phildimond/AlarmController/README.md

# AlarmController
 ESP32 Ethernet Alarm controller with MQTT integration
