phildimond/AlarmController/Hardware/Alarm input and PSU notes.pdf

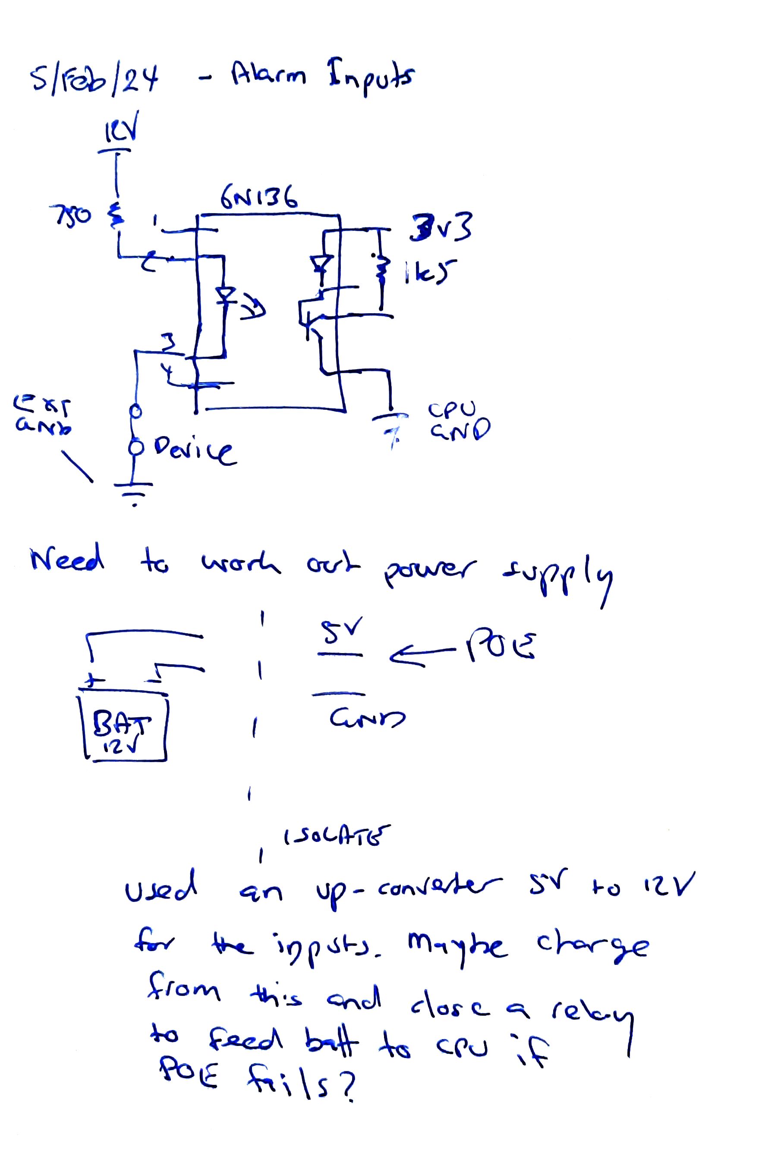
[picture p1: page 1]
