phildimond/AlarmController/Hardware/BatteryCharger/Charger Schematic.png

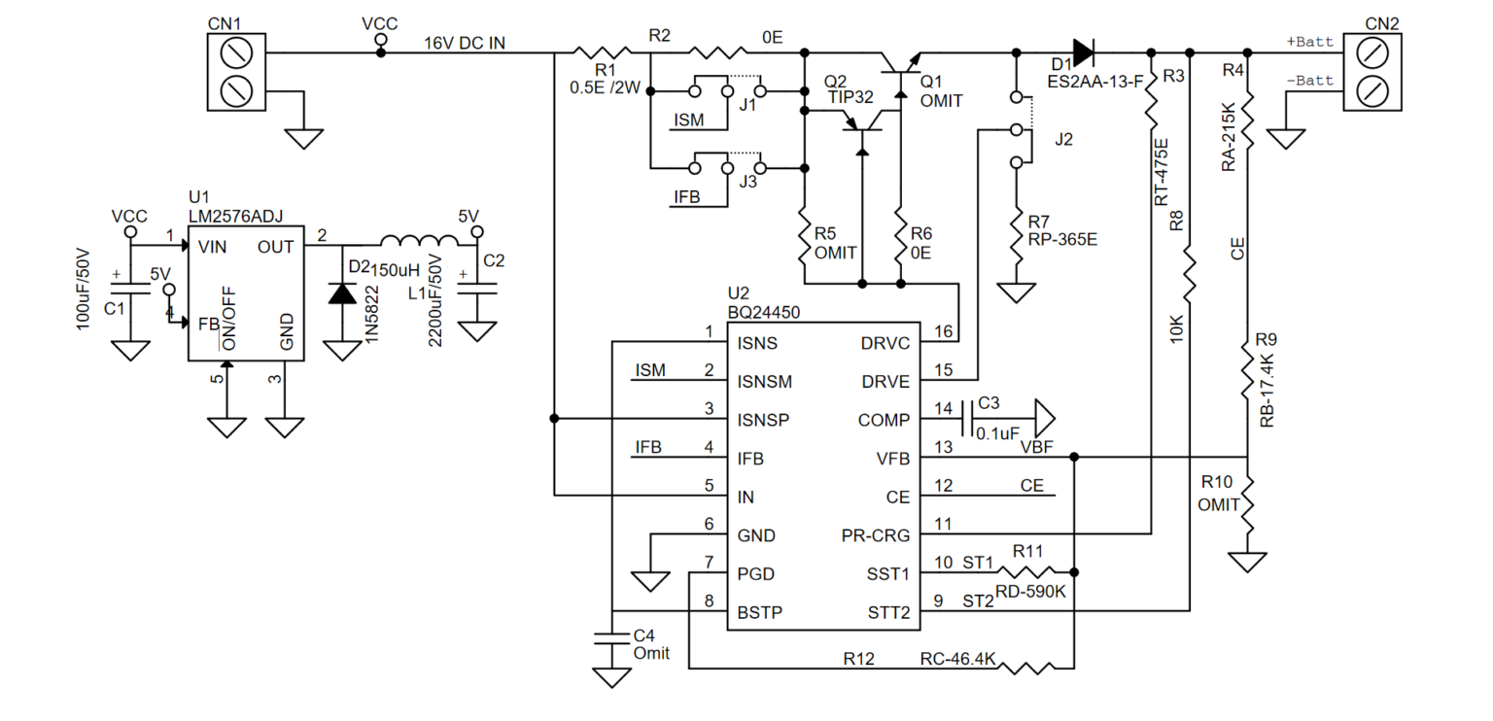
Hardware/BatteryCharger/Charger Schematic.png
