phildimond/AlarmController/Hardware/AlarmUnit/AlarmUnit.pdf

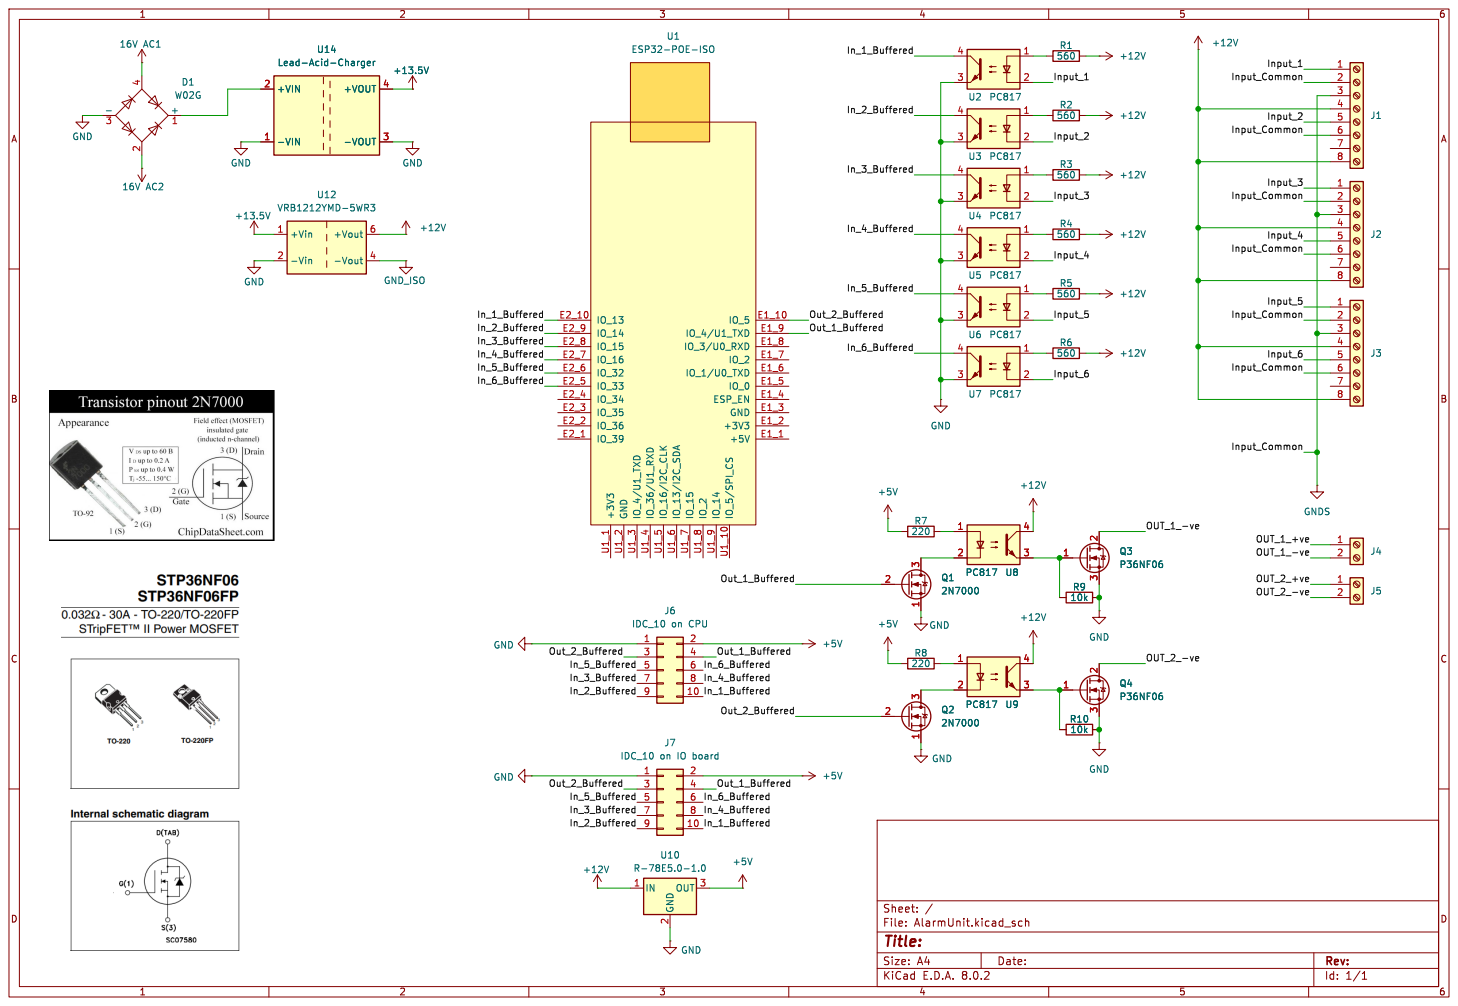
[picture p3: page 1]

IDC_10 on IO board
Id: 1/1 Title: File: AlarmUnit.kicad_sch Sheet: / 1
