phildimond/AlarmController/Hardware/BatteryCharger/Manufacturing/Battery Charger Schematic.pdf

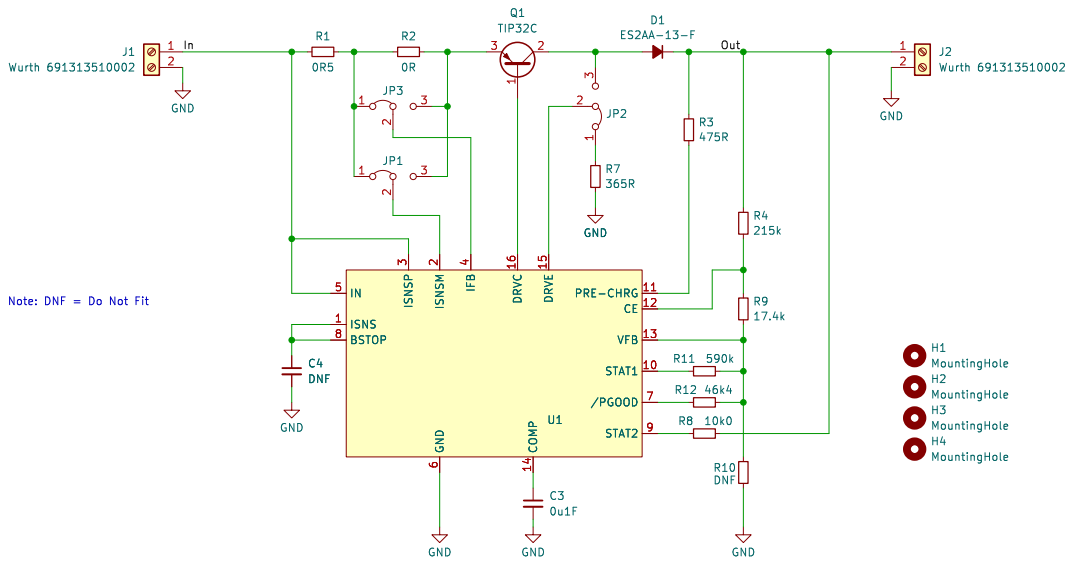
[picture p4: page 1]

H3 MountingHole H4 MountingHole H2 MountingHole H1 MountingHole R3
