phildimond/AlarmController/Hardware/BatteryCharger/Manufacturing/Battery Charger Board Check Actual.pdf

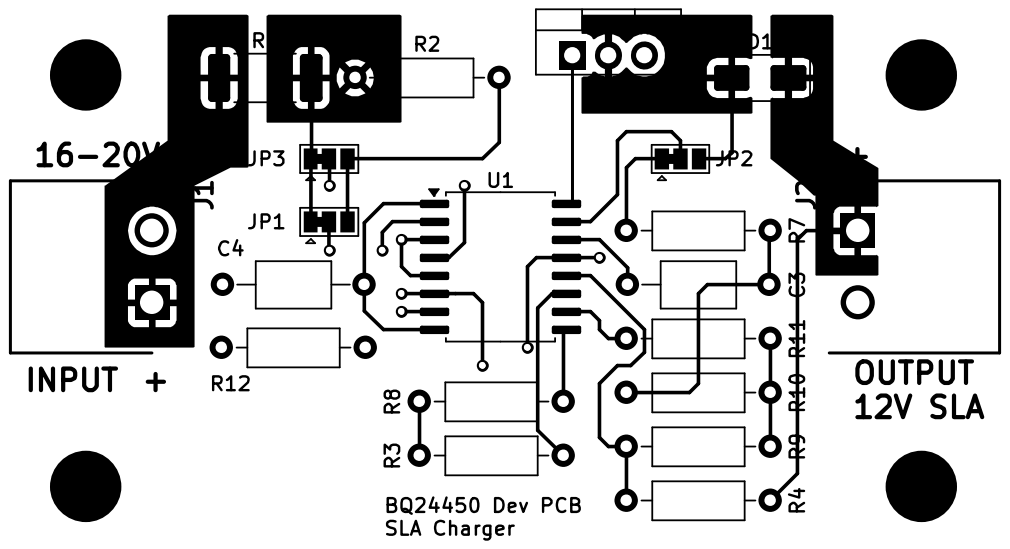
[picture p5: page 1]
