phildimond/AlarmController/Hardware/BatteryCharger/BatteryCharger.kicad_pcb

## KiCad design Hardware/BatteryCharger/BatteryCharger.kicad_pcb (2024-03-03)

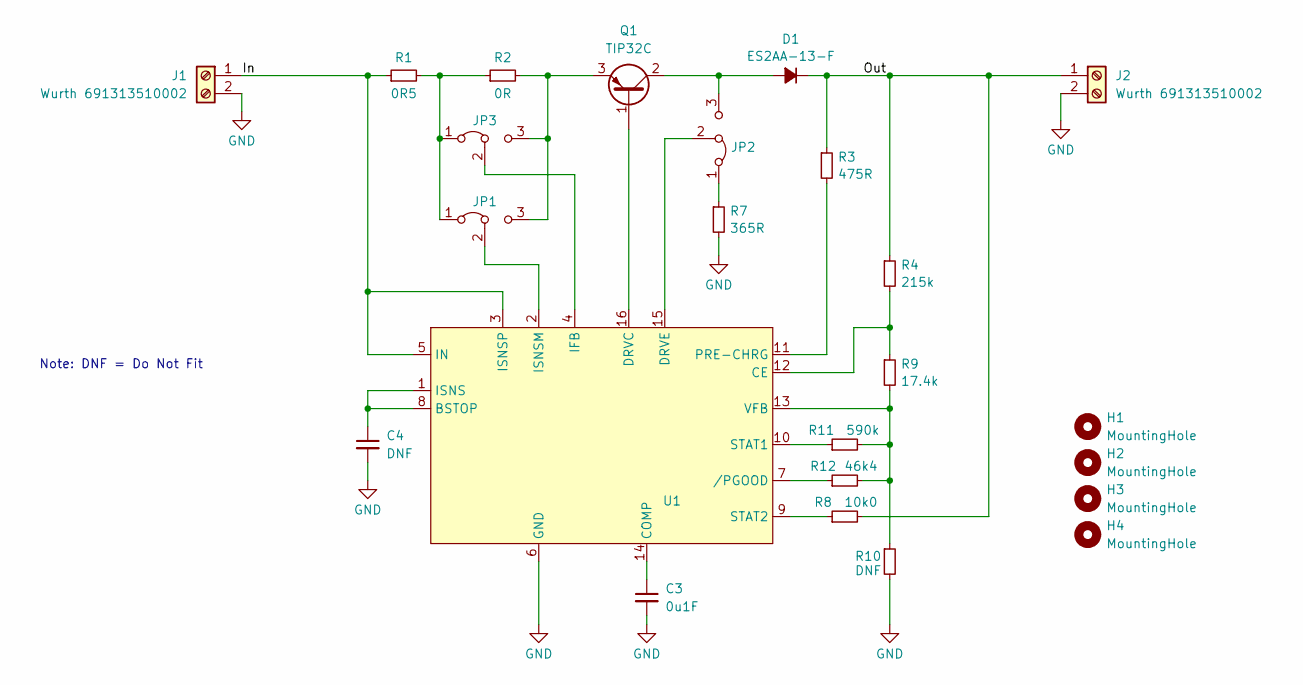
[picture p9: schematic BatteryCharger.kicad_sch]

Parts:
C3: 0u1F; C_Axial_L5.1mm_D3.1mm_P10.00mm_Horizontal
C4: DNF; C_Axial_L5.1mm_D3.1mm_P10.00mm_Horizontal
D1: ES2AA-13-F; D_SMA
H1, H2, H3, H4: MountingHole; MountingHole_3.2mm_M3
J1, J2: Wurth 691313510002; Wurth_691313510002_Pluggable_Terminal_Block
JP1, JP2, JP3: Jumper_3_Bridged12; SolderJumper-3_P1.3mm_Bridged12_Pad1.0x1.5mm
Q1: TIP32C; TO-220-3_Vertical
R1: 0R5; R_2512 Large Pad; Part CSRN2512FKR500
R2: 0R; R_Axial_DIN0207_L6.3mm_D2.5mm_P10.16mm_Horizontal; Part CSRN2512FKR500
R3: 475R; R_Axial_DIN0207_L6.3mm_D2.5mm_P10.16mm_Horizontal
R4: 215k; R_Axial_DIN0207_L6.3mm_D2.5mm_P10.16mm_Horizontal
R7: 365R; R_Axial_DIN0207_L6.3mm_D2.5mm_P10.16mm_Horizontal
R8: 10k0; R_Axial_DIN0207_L6.3mm_D2.5mm_P10.16mm_Horizontal
R9: 17.4k; R_Axial_DIN0207_L6.3mm_D2.5mm_P10.16mm_Horizontal
R10: DNF; R_Axial_DIN0207_L6.3mm_D2.5mm_P10.16mm_Horizontal
R11: 590k; R_Axial_DIN0207_L6.3mm_D2.5mm_P10.16mm_Horizontal
R12: 46k4; R_Axial_DIN0207_L6.3mm_D2.5mm_P10.16mm_Horizontal
U1: SOIC-16W_7.5x10.3mm_P1.27mm

Connections:
/In: J1.1, R1.1, U1.3 (ISNSP), U1.5 (IN)
/Out: D1.1 (K), J2.1, R3.1, R4.1, R8.2
GND: C3.2, C4.2, J1.2, J2.2, R7.2, R10.2, U1.6 (GND)
unnamed: D1.2 (A), JP2.3 (B), Q1.2 (C)
unnamed: JP1.1 (A), JP3.1 (A), R1.2, R2.1
unnamed: JP1.3 (B), JP3.3 (B), Q1.3 (E), R2.2
unnamed: JP1.2 (C), U1.2 (ISNSM)
unnamed: JP2.1 (A), R7.1
unnamed: JP2.2 (C), U1.15 (DRVE)
unnamed: JP3.2 (C), U1.4 (IFB)
unnamed: Q1.1 (B), U1.16 (DRVC)
unnamed: C4.1, U1.1 (ISNS), U1.8 (BSTOP)
unnamed: R4.2, R9.1, U1.12 (CE)
unnamed: C3.1, U1.14 (COMP)
unnamed: R3.2, U1.11 (PRE-CHRG)
unnamed: R11.1, U1.10 (STAT1)
unnamed: R8.1, U1.9 (STAT2)
unnamed: R9.2, R10.1, R11.2, R12.2, U1.13 (VFB)
unnamed: R12.1, U1.7 (/PGOOD)

Notes on the sheet:
Note: DNF = Do Not Fit

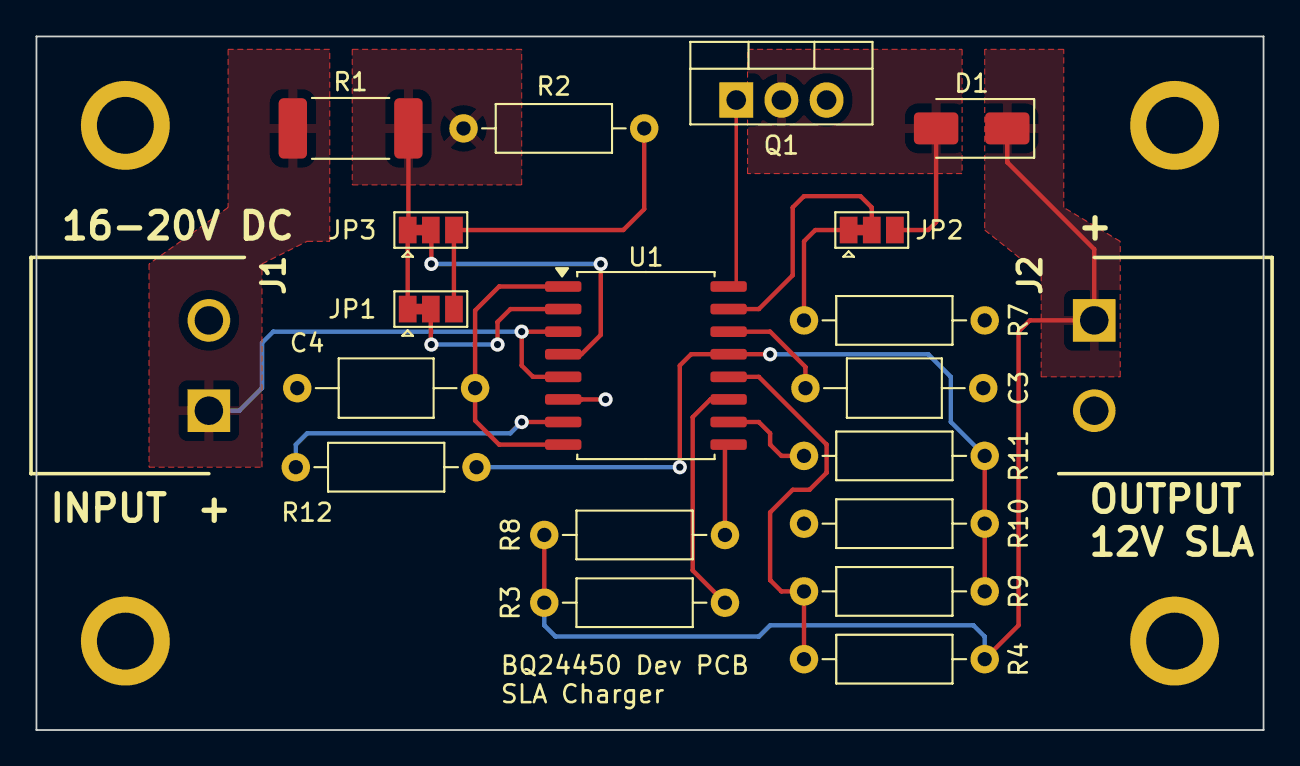
[picture p10: board BatteryCharger.kicad_pcb from above]

Board: 2 copper layers, 69.0 x 39.0 mm, 24 parts (0 on the bottom side), 19 nets.
