phildimond/AlarmController/main/utilities.c

/* C utilities
   
   General utility code for various projects.

   Copyright 2023 Phillip C Dimond

   Licensed under the Apache License, Version 2.0 (the "License");
   you may not use this file except in compliance with the License.
   You may obtain a copy of the License at

     http://www.apache.org/licenses/LICENSE-2.0

   Unless required by applicable law or agreed to in writing, software
   distributed under the License is distributed on an "AS IS" BASIS,
   WITHOUT WARRANTIES OR CONDITIONS OF ANY KIND, either express or implied.
   See the License for the specific language governing permissions and
   limitations under the License.

*/

#include <stdio.h>
#include <string.h>
#include "freertos/FreeRTOS.h"
#include "freertos/task.h"
#include "esp_err.h"
#include "esp_log.h"
#include "portmacro.h"

#include "defines.h"
#include "utilities.h"

// -------------------------------------------------------------------
// Log an error if it is not zero
// -------------------------------------------------------------------
void log_error_if_nonzero(const char *message, int error_code)
{
    if (error_code != 0) {
        ESP_LOGE(TAG, "Last error %s: 0x%x", message, error_code); 
    }
}

/*
    Read in a line of text from the console

    Params: buf: pointer to an allocated buffer
            len: allocated size of buffer
    Returns: length of string read or -1 for error
*/
int getLineInput(char buf[], size_t len)
{
    memset(buf, 0, len);
    fpurge(stdin); //clears any junk in stdin
    char *bufp;
    bufp = buf;
    while(1) {
        vTaskDelay(100/portTICK_PERIOD_MS);
        *bufp = getchar();
        if(*bufp != '\0' && *bufp != 0xFF && *bufp != '\r') { //ignores null input, 0xFF, CR in CRLF
            if(*bufp == '\n') {
                //'enter' (EOL) handler 
                *bufp = '\0';
                break;
            } 
            else if (*bufp == '\b') {
                //backspace handler
                if(bufp-buf >= 1) { 
                    putchar('\b');
                    bufp--; 
                }
            }
            else { 
                putchar(*bufp);
                bufp++; 
            } //pointer to next character
        }
        
        // Only accept len-1 characters, (len) character being null terminator.
        if(bufp-buf > (len)-2) {
            bufp = buf + (len -1);
            *bufp = '\0';
            break;
        }
    } 
    return (int)(bufp - buf);
}
