phildimond/AlarmController/(commit log)

2024-02-24 Added datasheets. Lost a lot of work when PC drive died!
    [BatteryCharger.kicad_pcb, BatteryCharger.kicad_sch]
2024-02-28 Working on the charger schematic
    [BatteryCharger.kicad_pcb, BatteryCharger.kicad_sch]
2024-02-29 Progress Check-in, working on schematic
    [BatteryCharger.kicad_sch]
2024-02-29 Progress check-in: working on charger schematic
    [BatteryCharger.kicad_sch]
2024-02-29 Progress: Finished schematic, starting on PCB
    [BatteryCharger.kicad_pcb, BatteryCharger.kicad_sch]
2024-03-01 Progress - Laying out PCB
    [BatteryCharger.kicad_pcb, BatteryCharger.kicad_sch]
2024-03-01 Initial PCB layout for charger
    [BatteryCharger.kicad_pcb]
2024-03-01 Board layout done, ready to check
    [BatteryCharger.kicad_pcb]
2024-03-02 Fix error on charger PCB and add mounting holes to schematic
    [BatteryCharger.kicad_pcb, BatteryCharger.kicad_sch]
2024-03-03 Charger: Minor PCB cleanup & generate manufacturing files
    [BatteryCharger-B_Cu.gbl, BatteryCharger-B_Cu.gbr, BatteryCharger-B_Mask.gbr, BatteryCharger-B_Mask.gbs, BatteryCharger-Edge_Cuts.gbr, BatteryCharger-Edge_Cuts.gm1, BatteryCharger-F_Cu.gbr, BatteryCharger-F_Cu.gtl]
2024-03-05 Ready to deploy
    Minor fixes, set all inputs to NC
    [defines.h, main.c, mqttProcess.c]
2024-03-17 Start Alarm unit layout
    [AlarmUnit.kicad_sch]
2024-04-03 Working on hardware design to add outputs
    [AlarmUnit.kicad_sch]
2024-04-18 Updated power circuits on alarm schematic
    [AlarmUnit.kicad_sch]
2024-05-04 Schematic Update
    [AlarmUnit.kicad_sch]
2024-05-26 Minor schematic changes
    [AlarmUnit.kicad_sch]
2024-05-30 Update schematic with CPU pins to connectors
    [AlarmUnit.kicad_sch]
